MilKris666/DCS-AH64D-CMWS-Control-Panel/(commit log)

2026-02-09 Initialize README with project details and instructions
    Added detailed project description and assembly instructions.
2026-02-09 Include timelapse video link in README
    Added link to timelapse video of assembly process.
2026-02-10 Add Arduino Mega compatibility note
    Added a note indicating the sketch is for Arduino Mega.
2026-02-11 Fix typo in README regarding Arduino IDE
